loggerhead-instruments/LS1-LS2/README.md

# LS1-LS2
LS1 and LS2 Firmware for version 2.x boards
