loggerhead-instruments/LS1-LS2/Altium/LS1-LS2-CAL/PCBWay/T-Y343W20819A-50sets-T-Y327W20819A-5sets-LS1-LS2(2024-07-02)(2024-09-10).xls

PCBWay Bom Quotation, Product No.:T-Y343W20819A
Item # | *Designator | *Qty | Manufacturer | *Mfg Part # | Description / Value | *Package/Footprint | Your Instructions / Notes | *Unit Price(50 sets) | *Total | *Delivery Time | *Actual Purchase Mfg Part # | *PCBWay Note | Customer Reply | PCBWay Update
1 | *1 | 1 | Abracon LLC | ABS06-32.768KHZ-1-T | XTAL_ABS06『 』CRYSTAL 32.7680KHZ 12.5PF SMD 10ppm『 』XTAL_ABS06 | XTAL-ABS06 |  | $0.554 | $27.700 | 7-10 Workdays | ABS06-32.768KHZ-1-T
2 | C2, C11, C16, C22, C24, C25, C26 | 7 |  |  | 1uF『 』Ceramic Chip Capacitor - X7R, 1%『 』C0402 | 0402 |  | $0.033 | $11.550 |  | GRM155Z71A105KE01D | GRM155Z71A105KE01D 10% 10V ,not 1% OK?『 』ok | yes
3 | C3, C6, C9, C14, C20, C30 | 6 |  |  | 10uF『 』Tantalum Capacitor, 20%, 6.3V or better『 』Tant0805 | Tant0805 |  | $0.148 | $44.400 | 7-10 Workdays | TMCP0J106MTRF | TMCP0J106MTRF 10uF ±20% 0805 OK？『 』ok | yes
4 | C4, C27, C31, C32 | 4 |  |  | 2.2uF『 』Ceramic Chip Capacitor - X7R, 1%『 』C0402 | 0402 |  | $0.066 | $13.200 |  | GRM155Z71A225KE01D | GRM155Z71A225KE01D 10% 10V ,not 1% OK?『 』ok | yes
5 | C7, C8, C10, C13, C15, C17, C19, C21 | 8 | Samsung Electro-Mechanics | 1276-1001-2-ND | 0.1uF『 』Ceramic Chip Capacitor - X7R, 10%『 』C0402 | 0402 |  | $0.002 | $0.800 |  | CL05B104KO5NNNC
6 | C12, C18, C23, C28, C33 | 5 |  |  | 0.01uF『 』Ceramic Chip Capacitor - X7R, 10%『 』C0402 | 0402 |  | $0.002 | $0.500 |  | CC0402KRX7R7BB103
7 | D1 | 1 | Rohm Semiconductor | SML-D12M1WT86TR-ND | LED_0603『 』SML-D12M1WT86 or similar green『 』LED_0603 | Diode0603 |  | $0.093 | $4.650 |  | SML-D12M1WT86
8 | D3 | 1 | Diodes Incorporated | DFLS130LDICT-ND | Shottky『 』DIODE SCHOTTKY 30V 1A PWRDI123『 』DFLS130 | DFLS130 |  | $0.121 | $6.050 |  | DFLS130L-7
9 | P1, P11 | 2 | Molex | WM4925-ND | 705530037『 』CONN HEADER R/A 3POS 2.54MM『 』Header 3 | HDR1X3 |  | $1.011 | $101.100 | 7-10 Workdays | 70553-0037
10 | P2 | 1 | Molex | WM4924-ND | 705530036『 』CONN HEADER R/A 2POS 2.54MM『 』Header 2 | HDR1X2 |  | $0.854 | $42.700 | 15Workdays | 70553-0036
11 | P3 | 1 | MPD (Memory Protection Devices) | BU2032SM-BT-GCT-ND | CoinCellHolder『 』BU2032SM-BT-GTR『 』CoinCellHolder | CoinCellHolder |  | $1.151 | $57.550 | 7-10 Workdays | BU2032SM-BT-GTR
12 | P4 | 1 | E-Switch | EG1903-ND | switch EG1218『 』EG1218『 』Header 3 | HDR1X3 |  | $0.513 | $25.650 |  | EG1218
13 | P5, P7, P9 | 3 | TE Connectivity ALCOSWITCH Switches | 450-1757-2-ND | pushbutton『 』FSM2JSMATR『 』pushbutton | SOP4 |  | $0.228 | $34.200 |  | FSM2JSMATR
14 | P6 | 1 | Hirose Electric Co Ltd | HR1941CT-ND | microSD Hirose『 』DM3D-SF『 』microSD Hirose | DM3D microSD |  | $1.066 | $53.300 |  | DM3D-SF
15 | P8 | 1 |  |  | Display『 』OLED 128x64 top yellow『 』Header 4 | HDR1X4 | DNP |  |  |  |  | [DNP不要贴];
16 | P13 | 1 | Molex | WM1399CT-ND | microUSB『 』20021121-00010C4LF CONN RCPT USB2.0 MICRO B SMD R/A『 』microUSB-B | microUSB-B |  | $0.262 | $13.100 |  | 1050170001 | The quoted part number is [1050170001], not [20021121-00010C4LF] as specified in description『 』ok | yes
17 | P14 | 1 | Amphenol ICC (FCI) | 609-3695-1-ND | 20021121-00010C4LF『 』CONN HEADER SMD 10POS 1.27MM『 』20021121-00010C4LF | AMPHENOL_20021121-00010C4LF |  | $0.703 | $35.150 |  | 20021121-00010C4LF
18 | R1 | 1 | Panasonic Electronic Components | P200KDBCT-ND | 200k .1%『 』ERA-3AEB204V RES SMD 200K OHM 0.1% 1/10W 0603『 』ERJ3RK | 3-0603 |  | $0.080 | $4.000 |  | ERA3AEB204V
19 | R2 | 1 | Panasonic Electronic Components | P68KBECT-ND | 68k 0.05%『 』ERA-3ARW683V RES SMD 68K OHM 0.05% 1/10W 0603『 』ERJ3RK | 3-0603 |  | $0.328 | $16.400 |  | ERA-3ARW683V
20 | R3, R4, R5, R6 | 4 | Panasonic Electronic Components |  | 10k『 』ERJ-3EKF1002V 10k 1% 0603『 』ERJ3RK | 3-0603 |  | $0.010 | $2.000 |  | ERJ3EKF1002V
21 | R7 | 1 | Panasonic Electronic Components |  | 330X『 』ERJ-3EKF3300V 330R 1% 0603『 』ERJ3RK | 3-0603 |  | $0.012 | $0.600 |  | ERJ3EKF3300V
22 | R8, R9 | 2 | Panasonic Electronic Components |  | 4.7k『 』ERJ-3EKF4701V 4.7k 1% 0603『 』ERJ3RK | 3-0603 |  | $0.012 | $1.200 |  | ERJ3EKF4701V
23 | R10 | 1 |  |  | DNP『 』Precision Thick Film Chip Resistor, 10 Ohm to 1M Ohm Range, 1% and 0.5% Tolerance, 0603 Size, 0.063 W『 』ERJ3RK | 3-0603 | DNP |  |  |  |  | [DNP不要贴];
24 | U2 | 1 | Analog Devices Inc./Maxim Integrated | DS3231M+TRLCT-ND | DS3231『 』IC RTC CLK/CALENDAR I2C 16SOIC『 』DS3231 | DS3231 |  | $8.000 | $400.000 |  | DS3231M+TRL
25 | U3, U5, U6 | 3 | Texas Instruments | LP3985IM5-3.3/NOPBTR-ND | LP3985IM5-3.3『 』Micropower, 150mA Low-Noise Ultra Low-Dropout CMOS Voltage Regulator『 』LP3985IM5-3.3 | MF05A_N |  | $0.465 | $69.750 |  | LP3985IM5-3.3/NOPB
26 | U4 | 1 | NXP USA Inc. | SGTL5000XNAA3R2CT-ND | SGTL5000『 』SGTL5000『 』SGTL5000 | QFN32 |  | $3.706 | $185.300 |  | SGTL5000XNAA3R2
27 | U7 | 1 | Texas Instruments | 296-32409-1-ND | TLV70018DCKR『 』Single Output LDO, 200 mA, Fixed 1.8 V Output, 2 to 5.5 V Input, with Low IQ, 5-pin SC70 (DCK), -40 to 125 degC, Green (RoHS & no Sb/Br)『 』TLV70018DCKR | TI-DCK5_V |  | $0.081 | $4.050 |  | TLV70018DCKR
28 | U8, U9 | 2 | Analog Devices Inc. | ADP1712AUJZ-3.3-R7CT-ND | ADP1712AUJZ-3.3-R7『 』IC REG LINEAR 3.3V 300MA TSOT5『 』LP3985IM5-3.3 | MF05A_N |  | $0.957 | $95.700 |  | ADP1712AUJZ-3.3-R7 | The quoted part number is [ADP1712AUJZ-3.3-R7], not [LP3985IM5-3.3] as specified in description『 』yes | yes
29 | U10 | 1 | NXP USA Inc. | MK20DX256VLH7-ND | MK20DX256VLH7『 』Kinetis K20『 』MK20DX256VLH7 | QFP50P1200X1200X160-64N |  | $11.392 | $569.600 | 7-10 Workdays | MK20DX256VLH7
30 | Y1 | 1 | EPSON | SER3913CT-ND | FA-20H_16.0000MF10Z-AJ3『 』16 MHz ±10ppm Crystal 8pF 80 Ohms 4-SMD, No Lead『 』FA-20H_16.0000MF10Z-AJ3 | XTAL_FA-20H_16.0000MF10Z-AJ3 |  | $1.546 | $77.300 | 7-10 Workdays | FA-20H 16.0000MF10Z-AJ3
 |  |  |  |  |  |  |  | Component Cost | $1897.50
 |  |  |  |  |  |  |  | Assembly Cost
 |  |  |  |  |  |  |  | PCB Cost
 |  |  |  |  |  |  |  | V5 Member 5% off | $0.00
 |  |  |  |  |  |  |  | All Total 50 Sets | $1897.50
