loggerhead-instruments/LS1-LS2/tools/logger-setup.html

# Loggerhead Snap/LS1

Check a logger, set its clock to UTC, and change its settings over USB.

1. Plug the logger into USB and turn it on. Wait for the menu screen.
2. Click Connect and pick the logger's port (usually a USB Serial / COM port).
3. Fix any issues listed, set the clock, and save your settings.

Connect Disconnect Not connected

## Device check

Refresh

Waiting for the logger...

## Clock

This computer (UTC)

Must be correct. Windows: Settings > Time > Sync now.

Logger (UTC)

Set logger to UTC now

## Settings

Waiting for the logger...

Save to logger Undo changes

Serial log
