loggerhead-instruments/LS1-LS2/(list of files, drawings)

Other design files:
Altium/LiBattPack8/LiBattPack8/LiBattPack8.PcbDoc
Altium/LiBattPack8/LiBattPack8/LiBattPack8.PrjPcb
Altium/LiBattPack8/LiBattPack8/LiBattPack8.SchDoc
Altium/LS1-LS2-CAL/LS1-LS2-CAL.PcbDoc
Altium/LS1-LS2-CAL/LS1-LS2-CAL.PrjPCB
Altium/LS1-LS2-CAL/LS1-LS2-CAL.SchDoc
Altium/LS1-LS2-CAL/LS1-LS2_audio.SchDoc
Altium/LS1-LS2/LS1-LS2.PcbDoc
Altium/LS1-LS2/LS1-LS2.PrjPCB
Altium/LS1-LS2/LS1-LS2.SchDoc
Altium/LS1-LS2/LS1-LS2_audio.SchDoc
