loggerhead-instruments/LS1-LS2/(commit log)

2021-03-11 fix clock, power measurements
    [LS1-LS2.ino, display.ino]
2021-03-11 power down microSD and disable SPI
2021-03-12 current draw set by sample rate
2021-03-14 leave cards powered on during record
    voltage regulator shut off if no card detected
2021-03-14 Can not get card switching to work
2023-03-13 v3.2 with LED
2023-03-22 v3.2 hex with LED
2024-06-30 v4 teensy chip on board
    [LS1-LS2.PcbDoc, LS1-LS2.PrjPCB, LS1-LS2.SchDoc, LS1-LS2_audio.SchDoc]
2024-06-30 make room for display
    [LS1-LS2.PcbDoc]
2024-07-24 move sd card closer to edge
    [LS1-LS2.PcbDoc, T-Y327W20819A-5sets-LS1-LS2(2024-07-02).xls]
2024-07-24 firmware v4
    This has different pin assignments than earlier versions.
    Will only work with version 4.
2024-07-29 fix voltage calculation
2024-11-19 updated voltage calculation for v4
    [LS1-LS2.GBL, LS1-LS2.GBO, LS1-LS2.GBP, LS1-LS2.GBS, LS1-LS2.GM1, LS1-LS2.GTL, LS1-LS2.GTO, LS1-LS2.GTP]
2024-12-21 fix display character overlap
    [LS1-LS2-v4.ino, display.ino]
2025-12-18 LS1-LS2-CAL
    changed 3.5mm audio port to one that was available and through hole
2026-04-12 switch sleep/wake to DS3231 alarm on pin 16 for v4.10
    Internal 32.768 kHz oscillator fails on conformal-coated boards.
    Use DS3231 external RTC alarm (INT on LLWU-capable pin 16) to wake
    from deepSleep (VLLS) instead of internal RTC timer (LLS), reducing
    sleep current. SD card powers down for sleeps >= 60s.
2026-04-12 remove SD card power-down during sleep
    VLLS deep sleep loses GPIO pin states, causing SPI pins to float
    and backfeed the SD card through ESD diodes (~2.67V). SD card
    draws the same current whether LDO is "off" or not, so skip the
    power-down/re-init cycle entirely. Also adds DS3231 OSF clear
    and recovery attempt at boot, and displays firmware version.
2026-10-27 retry SD card start after reset v4.30
    manualSettings() now makes up to 5 attempts to start the card and count
    its free space, power-cycling the card between attempts, instead of
    halting at "Card Fail" after one try. A free-space count of 0 is
    retried, since one failed read during the count also returns 0. If the
    card still won't start, resetFunc() is called rather than while(1).
    resetFunc() waits up to 2 s for the card to finish any operation in
    progress before cutting its power.
2026-10-29 DS3231 fallback clocks and low-voltage cutoff v4.40
    If the DS3231 stops answering or stops counting, switch to the Kinetis
    internal RTC, or to millis() plus calibrated LPTMR sleeps if that is not
    running either. The LPTMR also wakes the logger at least once a minute
    as a backup to the clock alarm. The internal RTC is kept synced to the
    DS3231 and to times set in the menu.
    Correction to 162a0f1: the internal 32.768 kHz oscillator does not fail
    on conformal-coated boards; the clock failures were bad DS3231 chips.
    Add a Cutoff menu item (Off, 3.0-3.4 V, default 3.3 V, EEPROM byte 24).
    After 3 low readings in a row at file changes, the logger powers down
    and sleeps until power is cycled.
    Co-A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
2026-10-29 show version only on splash; alternate RTC! with channels
    The version in the menu header looked like a voltage and overlapped the
    menu title. RTC! now alternates each second with Mono/Stereo instead of
    overlapping the title.
2026-10-29 read and change settings and device status from the setup page
    New USB commands in usb.ino: G reports device, clock, settings and
    status; S name=value changes one setting (menu ranges) and saves it;
    C clears the counters. T and R are unchanged.
    resetFunc() now counts restarts in EEPROM byte 25 and a low-battery
    stop sets byte 26, so a recovered logger shows whether it had SD
    trouble. The battery/memory estimate moved into calcDeployment() so the
    page and the screen report the same numbers.
    tools/set-time.html is now tools/logger-setup.html ("Loggerhead
    Snap/LS1"): device check with issues and fixes, readings, clock, and a
    settings form built from what the logger reports, so Snap 4 firmware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
2026-10-29 card-full sleep, free-space recheck, resume after SD restart
    - Card full: power down and sleep instead of while(1), and set EEPROM
    byte 27 so the setup page reports it. Shares stopForGood() with the
    low-battery stop.
    - When the file count reaches 0, count the card's free space before
    stopping: a failed count restarts, extra room keeps recording.
    - At power-up a free count of 0 or -1 (a failed read) restarts and
    retries instead of halting as if the card were full.
    - After a resetFunc() restart during a deployment, skip the 10-minute
    menu wait and the delay days. Uses EEPROM byte 28 plus the chip's
    reset source, so a power cycle always starts fresh. The unused
    byte-20 reset flag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
2026-10-29 add SD card write test that mirrors LS1-LS2-v4 recording
    Arduino/SDWriteTest writes files with the logger's SdFat calls, file
    size, names, folders and 16384-byte writes, paced at the audio rate,
    with the same stop, sleep (card powered) and standby steps between
    files. Times every write and shows results on the display; per-file
    lines on USB serial and a summary in WRTEST.TXT. fastFillGB fills part
    of the card back-to-back first.
2026-10-29 SD write test: UP+DOWN stop and no name clashes on rerun
    UP+DOWN stops the test as on the logger: the current file's wav header
    is updated to the length written, the file closed, results saved, and
    the display says it is safe to turn off. Checked after every write, in
    standby, and on each wake from sleep.
    A rerun on the same card starts its simulated dates a year later, and
    any remaining existing name is skipped instead of counted as an open
    error with a card restart.
2026-10-29 fix compile: declare fileMB in the main sketch
    checkSD() in LS1-LS2-v4.ino uses fileMB, but it was declared in
    display.ino, which Arduino places after the main sketch.
2026-10-29 wake on internal RTC alarm, sleep diagnostics v4.41
    A board locked up awake inside sleepUntil() (94 mA, display dark, LED
    off, I2C idle) without the DS3231 oscillator stopping. The internal
    RTC alarm now wakes the logger; the DS3231 is the time reference only,
    read and synced at each wake, with its alarm off so INT cannot wake the
    board. LPTMR backup stays in the same Snooze block.
    - DS3231 counts as stuck if its time does not change while the internal
    RTC advances 5 s, so a stop during sleep is caught.
    - readRTC() and rtcStatus() end with an I2C STOP.
    - sleepDiags (on in this build): each sleep and wake on USB serial with
    wake source, INT pin, internal RTC time and DS3231 registers.
    -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
2026-10-30 stop and restart audio properly around deep sleep, audio diagnostics v4.42
    Bench boards sometimes woke, opened the next file and got no audio
    (stuck after Queue Begin, 40 mA, no LED), the fault the 2024 code noted
    as 'no LRCLK signal or RX on Teensy'. Deep sleep stopped the clocks with
    the I2S transmitter and receive DMA still running.
    - audioSleep(): codec down over I2C, then i2sStop() stops the receiver
    and transmitter at a frame end, resets FIFOs, clears error flags and
    parks the receive DMA
    - I2S_modification() changes clocks and frame settings only while the
    I2S is stopped, then i2sStart() restarts it as the audio library does
    - I2S clock pins driven low before the codec power is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
2026-10-30 plan v4.50: correct lock-up cause, audio watchdog, start-up power cycle
    - the boards stuck awake were the 4.42 audio stall, not Wire or sleepUntil
    - audio watchdog: AudioInit() again, then restart, if no audio for 3 s
    - correct millis() after RTC alarm wakes (Snooze adds the LPTMR period)
    - LPTMR-only sleep when the internal RTC fails; DS3231 INT not used
    - why the April SD power-down failed (pins left on SPI)
    - SD Sleep help line 'ENTER:SD power down'
    - codec and hydrophone power cycle at every start (enables float in reset)
    - 4.50 builds with sleepDiags = 0
2026-10-30 watchdog, clock rules, SD Sleep, card back-off, audio watchdog v4.50
    Implements PLAN-v4.50.md (not yet compiled or bench tested):
    - 60 s hardware watchdog on the LPO, stopped in deep sleep; a watchdog
    reset during a deployment resumes and is counted; off for the stops
    - audio watchdog: no audio for 3 s restarts the audio, then the logger
    - DS3231 failed if stuck, silent or before 2026; internal RTC checked
    and dropped if it stops; clock gaps over 10 s counted; resume with
    the DS3231 stop flag set uses the internal RTC; clock switch recorded
    and shown as Clk:int; millis() corrected after each wake
    - cardOn()/cardOff() release the SPI pins before cutting power; SD Sleep
    menu setting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
2026-10-30 start-up: codec power cycle inside the serial wait; single display set-up
    The display stayed dark at power-up in 4.50. The codec and hydrophone
    are now switched off for 250 ms during the existing 500 ms serial wait,
    then on for 250 ms before the display uses the I2C bus. The second
    display.begin() at power-on is removed.
2026-10-30 start-up: same order as 4.42 up to the display; new steps after the splash
    Everything before display.begin() is back as in 4.42. The codec and
    hydrophone power cycle (250 ms off with the I2S clock pins low, 250 ms
    on) and the watchdog start now run after the splash is drawn, when
    nothing uses I2C.
2026-10-30 start-up: pins first, codec power cycle before I2C, 32 kHz load first
    - all pins set up in one block, then SGTL_EN low 250 ms (I2S clock pins
    low) and high 250 ms before Wire.begin(); hydrophone no longer toggled
    - rtcOscStart() sets the 26 pF crystal load at the start of setup()
    without stopping the oscillator, so it settles during start-up;
    internalRTCRunning() only checks that the RTC counts
2026-10-30 DS3231 reads back to the 4.40 transactions; say which start-up check fails
    A new DS3231S that the December 2024 firmware reads (time set from its
    menu survives a power cycle) is reported as failed by 4.50. readRTC()
    and rtcStatus() use the 4.40 and earlier I2C transactions again, and
    clockInit() prints 'DS3231 does not answer' or 'DS3231 answers but is
    not counting'.
2026-10-30 fix good DS3231 marked as failed at the first sync (since 4.41)
    setTeensyTime() called getTeensy3Time(0) for the menu autostart time.
    That inner call ran the DS3231 stuck check while its reference was
    still on the internal RTC's old time. At power-up the internal RTC holds
    the compile time (local, hours behind the DS3231's UTC), so the jump
    when it was synced looked like the DS3231 had stopped, and the logger
    switched to the internal clock.
    - setTeensyTime() sets autoStartTime from the new time directly
    - a sync moves the stuck check's reference by the internal RTC's jump
    - setTime2() resets the stuck check's reference times
2026-10-30 plan: I2C STOP item was not a real problem; record the DS3231 sync bug
2026-10-30 battery estimate uses 1.0 mA sleep when SD Sleep powers the card off
    Measured 0.7 mA at 4 V with an Amazon Basics card switched off in sleep
    (61 mA with it powered). Used when SD Sleep is Power off and the sleep
    setting is long enough for the card to be switched off.
2026-10-30 SD Sleep defaults to Power off
    The overnight battery test with the card powered off in long sleeps ran
    correctly. Boards that already stored a setting keep it.
2026-10-30 SD write test: logger's restart and card code, watchdog, hang report, SdFat 2.1.2
    A run hung for hours after a 2 s file close, leaving a half-written
    directory entry. The test now:
    - handles card errors with copies of the logger's resetFunc, restartLogger,
    card power and start functions, and resumes the run after a restart
    - runs the logger's 60 s watchdog; the step in progress is kept in the
    register file, and the watchdog interrupt saves PC and LR before the reset
    - powers the card off for sleeps of 2 min or more, as SD Sleep Power off
    - counts close errors, and keeps the run's counts in EEPROM from byte 1024
    - builds with its own copy of Teensyduino's SdFat 2.1.2 in src/SdFat; the
    l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
2026-10-30 logger builds with its own copy of SdFat 2.1.2, as the SD write test
    Teensyduino's SdFat 2.1.2 (PaulStoffregen/SdFat), the same copy as
    SDWriteTest/src/SdFat, replaces the SdFat-beta library, so both sketches
    build with a known version. blocksPerCluster() and cardSize() are renamed
    sectorsPerCluster() and sectorCount() in this version.
2026-11-05 update power consumption
2026-11-05 update power measurements
2026-11-09 setup page: battery-pack limit follows the device (Snap 12, LS 8); SdFat copy also in Snap4
2026-11-09 setup page: battery-pack hint for a Snap (1 = D-cell, 2 = 24 Ah lithium)
